littlebirdelectronics/shakey/Images/3-Shakeys.jpg

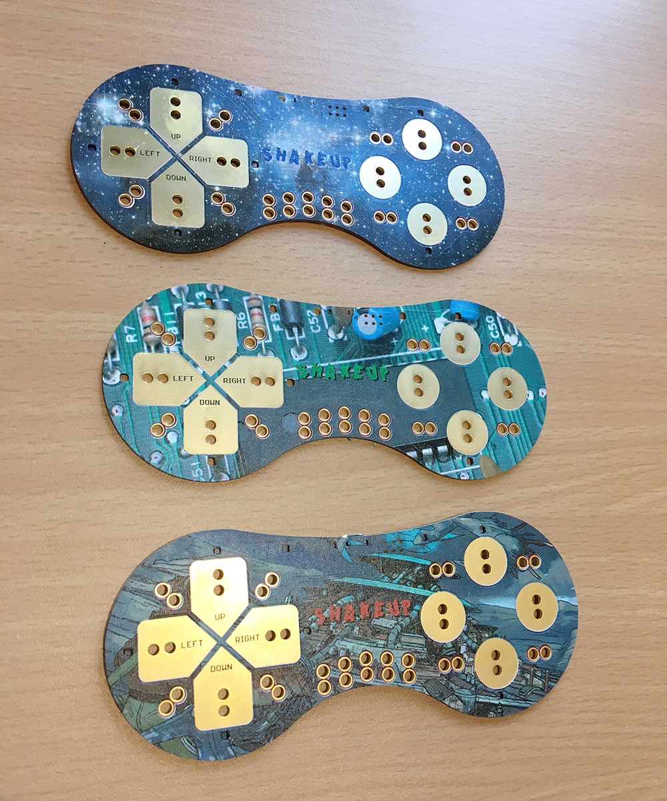
Images/3-Shakeys.jpg
