littlebirdelectronics/shakey/Images/PCB Back.jpg

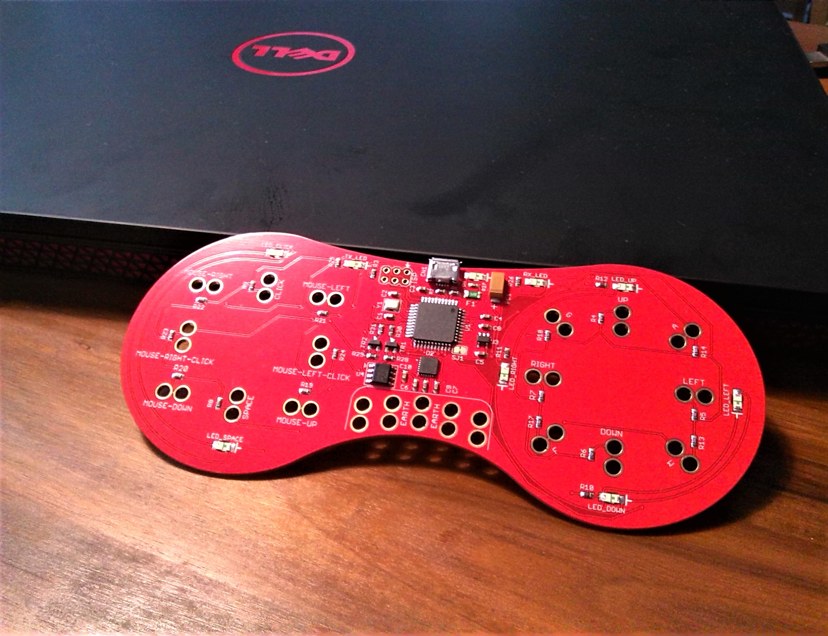
Images/PCB Back.jpg
