littlebirdelectronics/shakey/Images/abstract-small.jpg

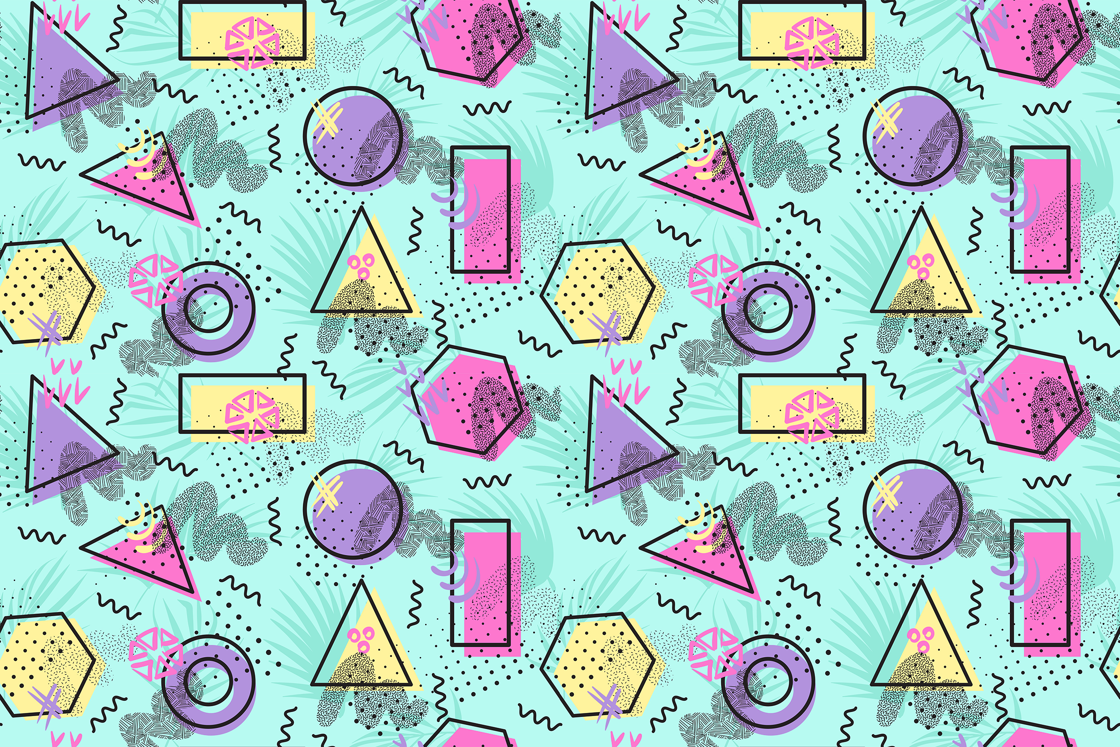
Images/abstract-small.jpg
