littlebirdelectronics/shakey/Images/jlcpcb_complain.JPG

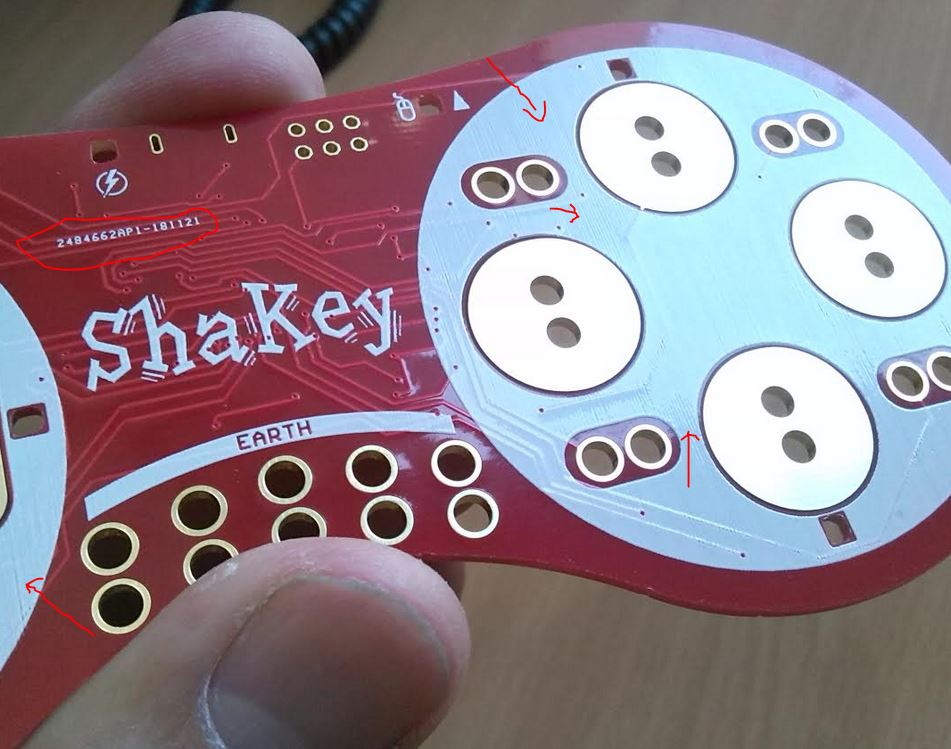
Images/jlcpcb_complain.JPG
