littlebirdelectronics/shakey/Images/MOS6581_chtaube061229.jpg

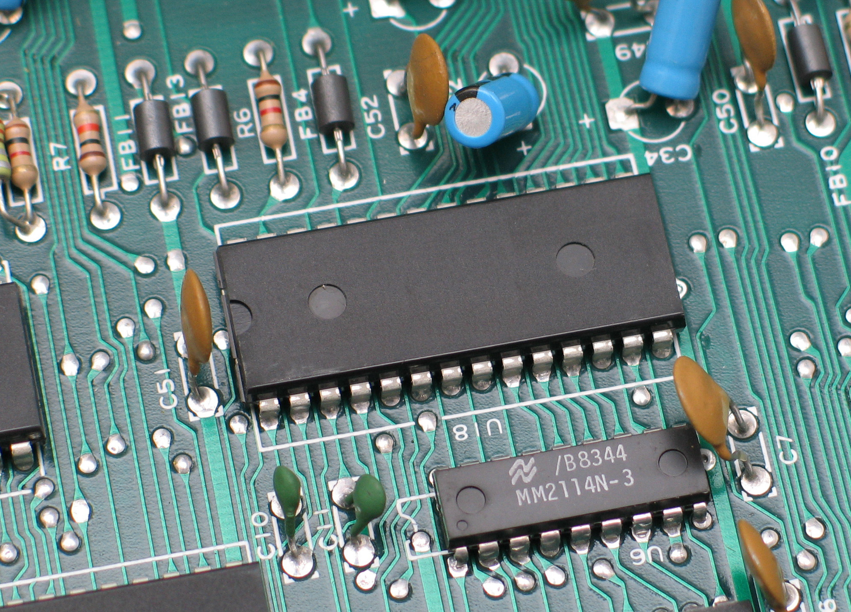
Images/MOS6581_chtaube061229.jpg
