littlebirdelectronics/shakey/Images/PCB Front.jpg

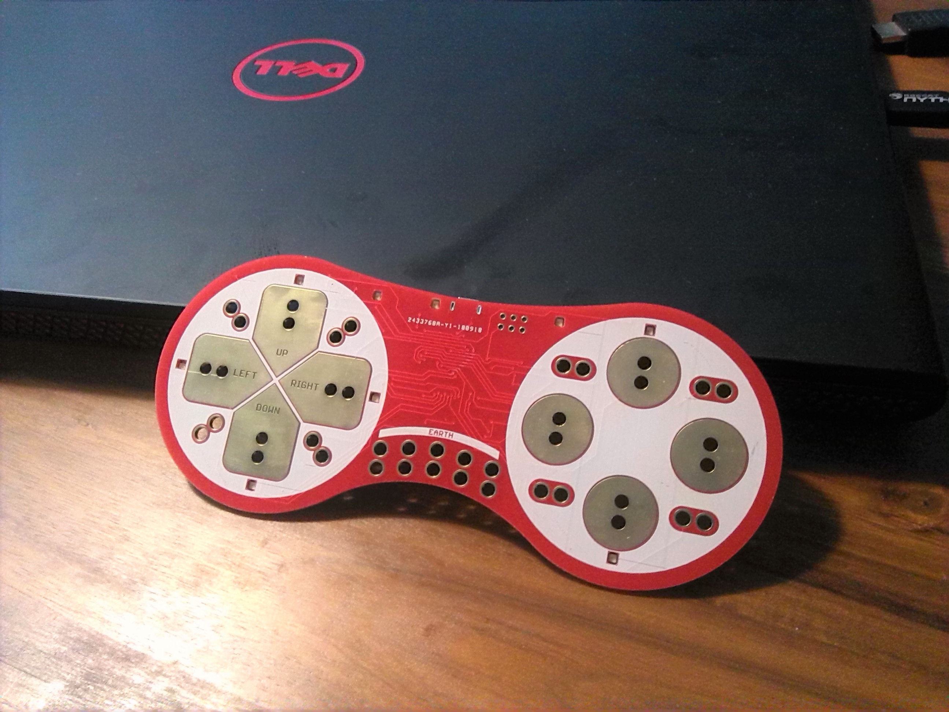
Images/PCB Front.jpg
