littlebirdelectronics/shakey/Production/BOM/2018-11-02T052132.xlsx

Index | Quantity | Part Number | Manufacturer Part Number | Description | Customer Reference | Available | Backorder | Unit Price | Extended Price USD
1 | 1000 | AP2112K-3.3TRG1DIDKR-ND | AP2112K-3.3TRG1 | IC REG LINEAR 3.3V 600MA SOT25 | U3 | 1000 | 0 | 0.13041 | 130.41
2 | 1000 | ATMEGA32U4-AU-ND | ATMEGA32U4-AU | IC MCU 8BIT 32KB FLASH 44TQFP | U1 | 1000 | 0 | 3.4196 | 3419.60
3 | 4000 | 1276-1258-2-ND | CL10F104ZO8NNNC | CAP CER 0.1UF 16V Y5V 0603 | C4, C6, C10 | 4000 | 0 | 0.00693 | 27.72
4 | 4000 | 1276-2082-2-ND | CL10B474KA8NFNC | CAP CER 0.47UF 25V X7R 0603 | C9 | 4000 | 0 | 0.01651 | 66.02
5 | 4000 | 1276-6524-2-ND | CL10B105MO8NNWC | CAP CER 1UF 16V X7R 0603 | C3, C5, C8 | 4000 | 0 | 0.00787 | 31.46
6 | 4000 | 1276-1888-2-ND | CL10A225MQ8NNNC | CAP CER 2.2UF 6.3V X5R 0603 | C7 | 4000 | 0 | 0.02093 | 83.72
7 | 1000 | 478-10747-6-ND | TAJC106M016SNJ | CAP TANT 10UF 20% 16V 2312 | PC1 | 1000 | 0 | 0.14864 | 148.64
8 | 1000 | SER4046TR-ND | FA-238 16.0000MB-K3 | CRYSTAL 16.00 MHZ 10PF SMD | Y1 | 1000 | 0 | 0.19251 | 192.51
9 | 1000 | 1428-1059-6-ND | ICM-20689 | IMU ACCEL/GYRO/TEMP I2C/SPI QFN | U2 | 1000 | 0 | 2.98965 | 2989.65
10 | 6000 | 160-1456-2-ND | LTST-C230KGKT | LED GREEN CLEAR CHIP SMD | LED_CLICK, LED_DOWN, LED_LEFT, LED_RIGHT, LED_SP | 6000 | 0 | 0.0476 | 285.60
11 | 1000 | 160-1457-6-ND | LTST-C230KRKT | LED RED CLEAR CHIP SMD | ON | 1000 | 0 | 0.06054 | 60.54
12 | 2000 | 160-1458-6-ND | LTST-C230KSKT | LED YELLOW CLEAR CHIP SMD | RX_LED,TX_LED | 2000 | 0 | 0.07304 | 146.08
13 | 1000 | 568-10295-6-ND | LM75AD,118 | SENSOR DIGITAL -55C-125C 8SO | U4 | 1000 | 0 | 0.33734 | 337.34
14 | 2000 | BSS138DKR-ND | BSS138 | MOSFET N-CH 50V 220MA SOT-23 | TR1,TR2 | 2000 | 0 | 0.06041 | 120.82
15 | 1000 | 507-1802-6-ND | 0ZCJ0050FF2G | PTC RESET FUSE 8V 500MA 1206 | F1 | 1000 | 0 | 0.07996 | 79.96
16 | 5000 | RMCF0603JT10K0TR-ND | RMCF0603JT10K0 | RES 10K OHM 5% 1/10W 0603 | R3, R28, R29, R30, R31 | 5000 | 0 | 0.00188 | 9.41
17 | 5000 | 311-1.0KGRTR-ND | RC0603JR-071KL | RES SMD 1K OHM 5% 1/10W 0603 | R25, R26, R27 | 5000 | 0 | 0.00268 | 13.41
18 | 20000 | P22MGTR-ND | ERJ-3GEYK226V | RES SMD 22M OHM 10% 1/10W 0603 | R4, R5, R6, R7, R8, R9, R13, R14, R17, R18, R19, | 20000 | 0 | 0.0028 | 55.94
19 | 5000 | RMCF0603JT22R0TR-ND | RMCF0603JT22R0 | RES 22 OHM 5% 1/10W 0603 | R1, R2 | 5000 | 0 | 0.00188 | 9.41
20 | 5000 | RMCF0603JT330RTR-ND | RMCF0603JT330R | RES 330 OHM 5% 1/10W 0603 | R10, R11, R12 | 5000 | 0 | 0.00188 | 9.41
21 | 1000 | SCP390-ND | 10057 | BAG 5X7" STATIC SHIELD 1=1EA |  | 1000 | 0 | 0.089 | 89.00
22 | 4000 | 1276-2149-2-ND | CL10C100CB81PNC | CAP CER 10PF 50V C0G/NP0 0603 | C1,C2 | 4000 | 0 | 0.01648 | 65.90
