littlebirdelectronics/shakey/Production/BOM/Shakey_default_BOM_values.xls

Total Price | Need Qty | Qty | Value | Device | Parts | Library | Description | DESCRIPTION | MF | MPN | OC_DIGIKEY | SUPPLIER | UNITPRICE | URL
0.13041 | 1 | 1 | AP2210K-3.3TRG1 | AP2210K-3.3TRG1 | U3 | SixthLogic | The AP2210 is a 300mA ULDO regulator which provides very low | IC REG LDO 3.3V 0.3A SOT23-5 | Diodes Inc | AP2112K-3.3TRG1 | AP2112K-3.3TRG1DIDKR-ND |  | $0.13041 | https://www.digikey.com/product-detail/en/diodes-incorporated/AP2210K-3.3TRG1/AP2210K-3.3TRG1DITR-ND/4470819 | Replace with AP2112K-3.3TRG1 to match EagLED
3.04 | 1 | 1 | ATMEGA32U4-AU | ATMEGA32U4-AU | U1 | SixthLogic | Atmel ATmega32u4 MCU, 32KByte | IC MCU 8BIT 32KB FLASH | Microchip Technology | ATMEGA32U4-AU | ATMEGA32U4-AU-ND |  | $3.04 | https://www.digikey.com/product-detail/en/microchip-technology/ATMEGA32U4-AU/ATMEGA32U4-AU-ND/1914602
0.02079 | 3 | 3 | 0.1uF | C-EUC0603 | C4, C6, C10 | rcl | CAPACITOR, European symbol | CAP CER 0.1UF 50V X7R 0603 | Samsung Electro-Mechanics | CL10B104KB8NNNC | 1276-1000-2-ND | Digikey | $0.00693 | https://www.digikey.com/product-detail/en/samsung-electro-mechanics/CL10F104ZO8NNNC/1276-1258-2-ND/3886916
0.01651 | 1 | 1 | 0.47uF | C-EUC0603 | C9 | rcl | CAPACITOR, European symbol | CAP CER 0.47UF 16V X7R 0603 | Murata Electronics North America | GCM188R71C474KA55D | 490-4775-2-ND | Digikey | $0.01651 | https://www.digikey.com/product-detail/en/CL10B474KA8NFNC/1276-2082-2-ND/3887740/?itemSeq=276083693
0.02361 | 3 | 3 | 1uF | C-EUC0603 | C3, C5, C8 | rcl | CAPACITOR, European symbol | CAP CER 1UF 25V X5R 0603 | Samsung Electro-Mechanics | CL10A105KA8NNNC | 1276-1102-2-ND | Digikey | $0.00787 | https://www.digikey.com/product-detail/en/samsung-electro-mechanics/CL10B105MO8NNWC/1276-6524-2-ND/5961008
0.02093 | 1 | 1 | 2.2uF | C-EUC0603 | C7 | rcl | CAPACITOR, European symbol | CAP CER 2.2UF 16V X5R 0603 | Samsung Electro-Mechanics | CL10A225KO8NNNC | 1276-1040-2-ND | Digikey | $0.02093 | https://www.digikey.com/product-detail/en/samsung-electro-mechanics/CL10A225MQ8NNNC/1276-1888-2-ND/3887546
0.03014 | 2 | 2 | 22p | C-EUC0603 | C1, C2 | rcl | CAPACITOR, European symbol | CAP CER 22PF 16V C0G/NP0 0603 | KEMET | C0603C220K4GACTU | 399-9031-2-ND | Digikey | $0.01507 | https://www.digikey.com/product-detail/en/yageo/CC0603JRNPO0BN220/311-1755-2-ND/5195164
0.14864 | 1 | 1 | 10uF | CAP_POL-CT6032 | PC1 | SixthLogic | Capacitor with Polarity | CAP TANT 10UF 20V 10% 2312 | KEMET | T491C106K020AT7280 | 399-10158-2-ND | Digikey | $0.14864 | https://www.digikey.com/product-detail/en/avx-corporation/TAJC106M016SNJ/478-10747-6-ND/7537038
0.07954 | 1 | 1 | CONN_USB-4UCON-11071 | CONN_USB-4UCON-11071 | CN1 | SixthLogic | USB Connector | B TYPE FEMALE 05P SMT 90ﾰ WITHOUT POST 2 SHELL TABS | 4UCON | 11071 |  |  | $0.07954 | http://www.4uconnector.com/online/Itemadrawing.asp?fldseries=11071&seriesno_a=1006
0.19251 | 1 | 1 | 16Mhz | CRYSTAL_GROUNDED_2GND-FA-238 | Y1 | SixthLogic | 4 PIN SMD Crystal | CRYSTAL 16.0000MHZ 18PF SMD | EPSON | FA-238 16.0000MB-C3 | SER3686TR-ND | Digikey | $0.19251 | https://www.digikey.com/product-detail/en/FA-238+16.0000MB-K3/SER4046TR-ND/5175005/?itemSeq=276086705
3.10196 | 1 | 1 | ICM-20689 | ICM-20689 | U2 | SixthLogic | High Performance 6-Axis MEMS MotionTrackingﾙ Device in 4x4 mm Package | IMU ACCEL/GYRO/TEMP I2C/SPI QFN | TDK InvenSense | ICM-20689 | 1428-1059-2-ND | Digikey | $3.10196 | https://www.digikey.com/product-detail/en/tdk-invensense/ICM-20689/1428-1059-2-ND/5872869
0.28704 | 6 | 6 | GREEN | LED-1206-LTST-BOTTOM | LED_CLICK, LED_DOWN, LED_LEFT, LED_RIGHT, LED_SPACE, LED_UP | SixthLogic |  | LED GREEN CLEAR CHIP SMD | Lite-On Inc. | LTST-C230KGKT | 160-1456-2-ND | Digikey | $0.04784 | https://www.digikey.com/product-detail/en/lite-on-inc/LTST-C230KGKT/160-1456-2-ND/386855
0.05668 | 1 | 1 | RED | LED-1206-LTST-BOTTOM | ON | SixthLogic |  | LED RED CLEAR CHIP SMD | Lite-On Inc. | LTST-C230KRKT | 160-1457-2-ND | Digikey | $0.05668 | https://www.digikey.com/product-detail/en/lite-on-inc/LTST-C230KRKT/160-1457-2-ND/386857
0.1119 | 2 | 2 | YELLOW | LED-1206-LTST-BOTTOM | RX_LED, TX_LED | SixthLogic |  | LED YELLOW CLEAR CHIP SMD | Lite-On Inc. | LTST-C230KSKT | 160-1458-2-ND | Digikey | $0.05595 | https://www.digikey.com/product-detail/en/lite-on-inc/LTST-C230KSKT/160-1458-2-ND/386859
0.28743 | 1 | 1 | LM75AD | LM75AD | U4 | SixthLogic | LM75 | SENSOR DIGITAL -55C-125C 8SO | NXP USA Inc. | LM75AD,118 | 568-10295-2-ND | Digikey | $0.28743 | https://www.digikey.com/product-detail/en/nxp-usa-inc/LM75AD118/568-10295-2-ND/1692795
0.12782 | 2 | 2 | BSS138 | MOSFET-N-BSS138 | TR1, TR2 | SixthLogic |  | MOSFET N-CH 50V 220MA SOT-23 | ON Semiconductor | BSS138 | BSS138TR-ND | Digikey | $0.06391 | https://www.digikey.com/product-detail/en/on-semiconductor/BSS138/BSS138TR-ND/244210
0.07996 | 1 | 1 | 500mA | PPTC-1206 | F1 | SixthLogic |  | PTC RESET FUSE 8V 500MA 1206 | Bel Fuse Inc. | 0ZCJ0050FF2G | 507-1802-6-ND | Digikey | $0.07996 | https://www.digikey.com/product-detail/en/bel-fuse-inc/0ZCJ0050FF2G/507-1802-6-ND/4156237
0.0094 | 5 | 5 | 10K | R-EU_R0603 | R3, R28, R29, R30, R31 | rcl | RESISTOR, European symbol | RES 10K OHM 5% 1/10W 0603 | Stackpole Electronics Inc. | RMCF0603JG10K0 | RMCF0603JG10K0TR-ND | Digikey | $0.00188 | https://www.digikey.com/product-detail/en/stackpole-electronics-inc/RMCF0603JG10K0/RMCF0603JG10K0TR-ND/1712133
0.00804 | 3 | 3 | 1K | R-EU_R0603 | R25, R26, R27 | rcl | RESISTOR, European symbol | RES SMD 1K OHM 5% 1/10W 0603 | Yageo | RC0603JR-071KL | 311-1.0KGRTR-ND | Digikey | $0.00268 | https://www.digikey.com/product-detail/en/yageo/RC0603JR-071KL/311-1.0KGRTR-ND/726677
0.0448 | 16 | 16 | 22M | R-EU_R0603 | R4, R5, R6, R7, R8, R9, R13, R14, R17, R18, R19, R20, R21, R22, R23, R24 | rcl | RESISTOR, European symbol | RES SMD 22M OHM 10% 1/10W 0603 | Panasonic Electronic Components | ERJ-3GEYK226V | P22MGTR-ND | Digikey | $0.00280 | https://www.digikey.com/product-detail/en/panasonic-electronic-components/ERJ-3GEYK226V/P22MGTR-ND/282153
0.00376 | 2 | 2 | 22R | R-EU_R0603 | R1, R2 | rcl | RESISTOR, European symbol | RES 22 OHM 5% 1/10W 0603 | Stackpole Electronics Inc. | RMCF0603JT22R0 | RMCF0603JT22R0TR-ND | Digikey | $0.00188 | https://www.digikey.com/product-detail/en/stackpole-electronics-inc/RMCF0603JT22R0/RMCF0603JT22R0TR-ND/1758012
0.00564 | 3 | 3 | 330R | R-EU_R0603 | R10, R11, R12 | rcl | RESISTOR, European symbol | RES 330 OHM 5% 1/10W 0603 | Stackpole Electronics Inc. | RMCF0603JT330R | RMCF0603JT330RTR-ND | Digikey | $0.00188 | https://www.digikey.com/product-detail/en/stackpole-electronics-inc/RMCF0603JT330R/RMCF0603JT330RTR-ND/1757998
0.089 | 1 | 1 |  |  |  |  |  | Anti-static bag 5x7” |  |  |  |  | $0.089
7.91651
Make Qty | 1
