littlebirdelectronics/shakey/Images/SNES_Outline2.dxf

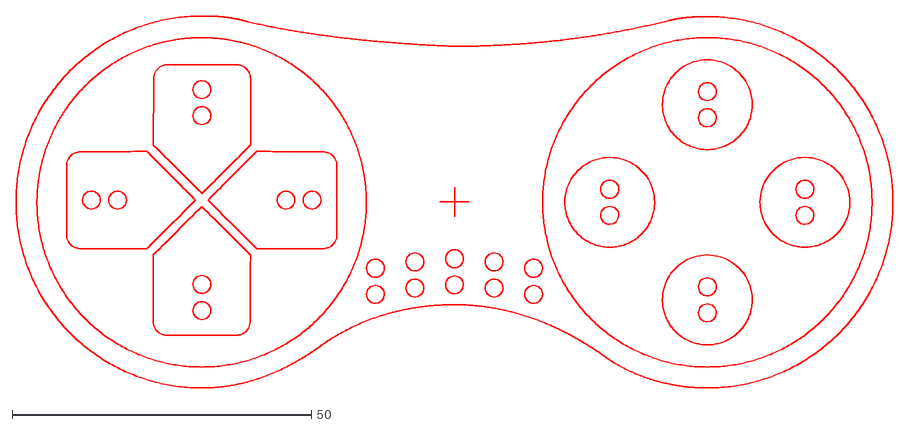
[picture p7: CAD file, 2019-06-05]
Images/SNES_Outline2.dxf
146.4 x 62.1
