littlebirdelectronics/shakey/Shakey.dxf

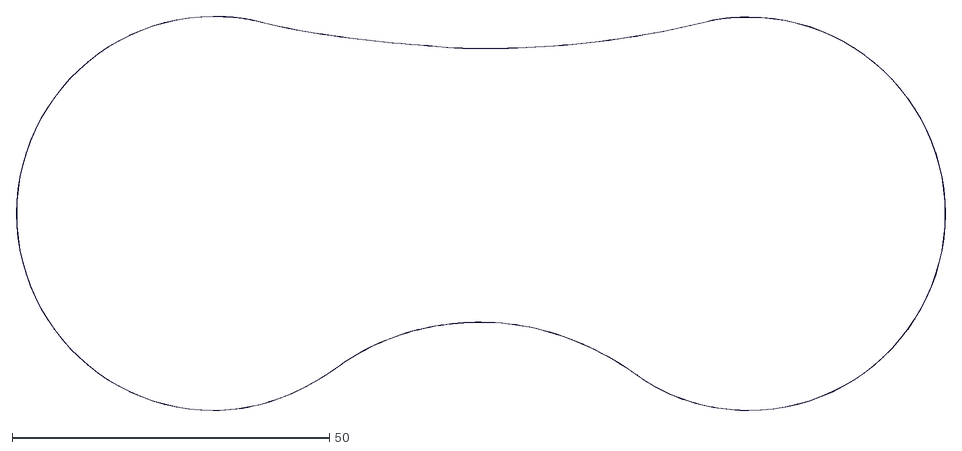
[picture p8: CAD file, 2018-12-04]
Shakey.dxf
146.5 x 62.2
