littlebirdelectronics/shakey/Images/TestJig.dxf

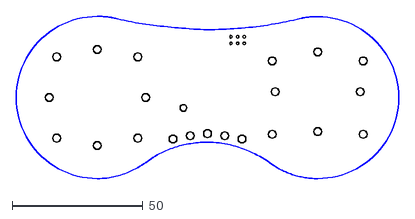
[picture p9: CAD file, 2019-03-15]
Images/TestJig.dxf
146.4 x 62.1
