littlebirdelectronics/shakey/Images/Untitled.dxf

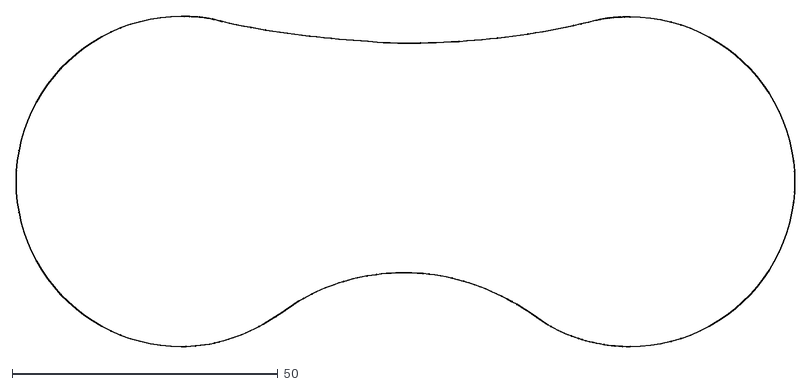
[picture p10: CAD file, 2018-12-04]
Images/Untitled.dxf
146.5 x 62.2
