littlebirdelectronics/shakey/Images/Outline.dxf

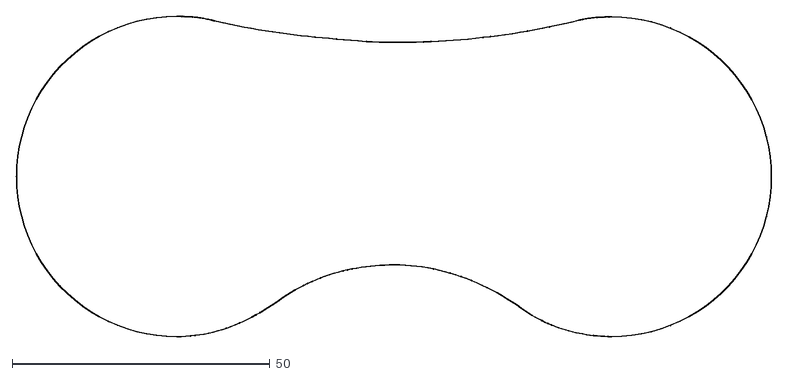
[picture p11: CAD file, 2018-12-04]
Images/Outline.dxf
146.5 x 62.2
