littlebirdelectronics/shakey/Images/side_holder.dxf

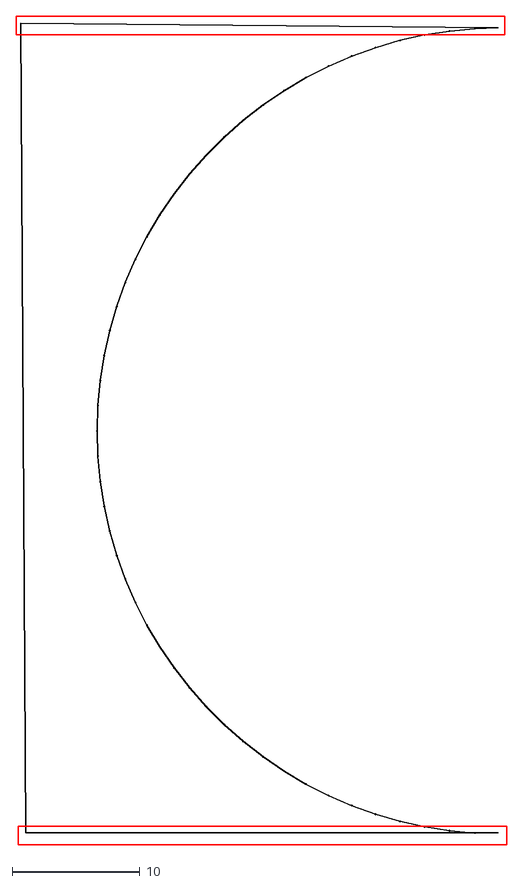
[picture p12: CAD file, 2018-12-04]
Images/side_holder.dxf
38.4 x 64.8
