littlebirdelectronics/shakey/Images/Shakey-Outline.dxf

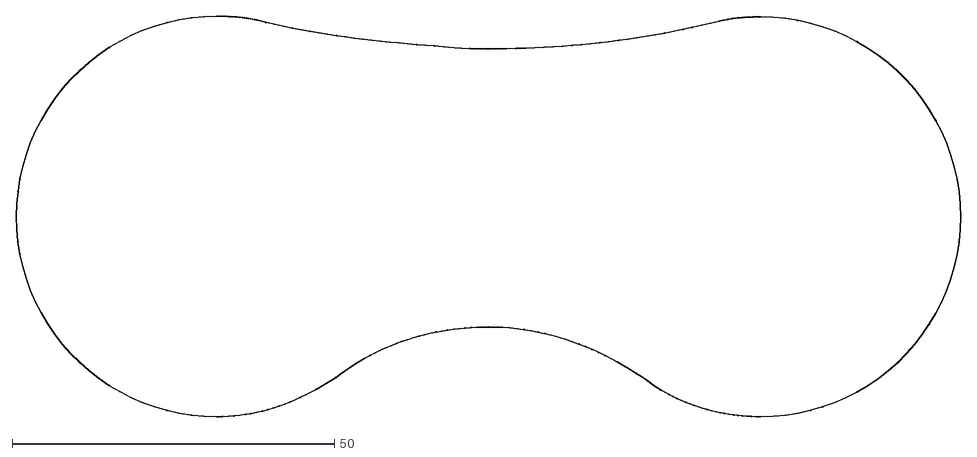
[picture p13: CAD file, 2018-12-04]
Images/Shakey-Outline.dxf
146.5 x 62.2
