littlebirdelectronics/shakey/Images/Australian-Made.dxf

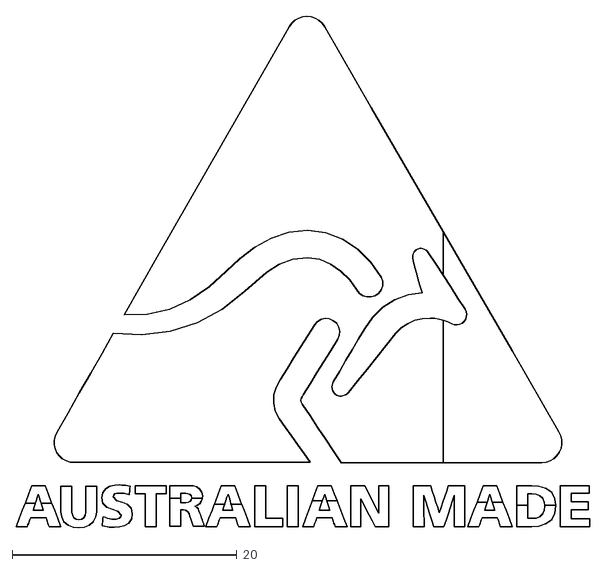
[picture p14: CAD file, 2018-11-09]
Images/Australian-Made.dxf
51.1 x 45.6
