littlebirdelectronics/shakey/Images/test_made_in_australia.dxf

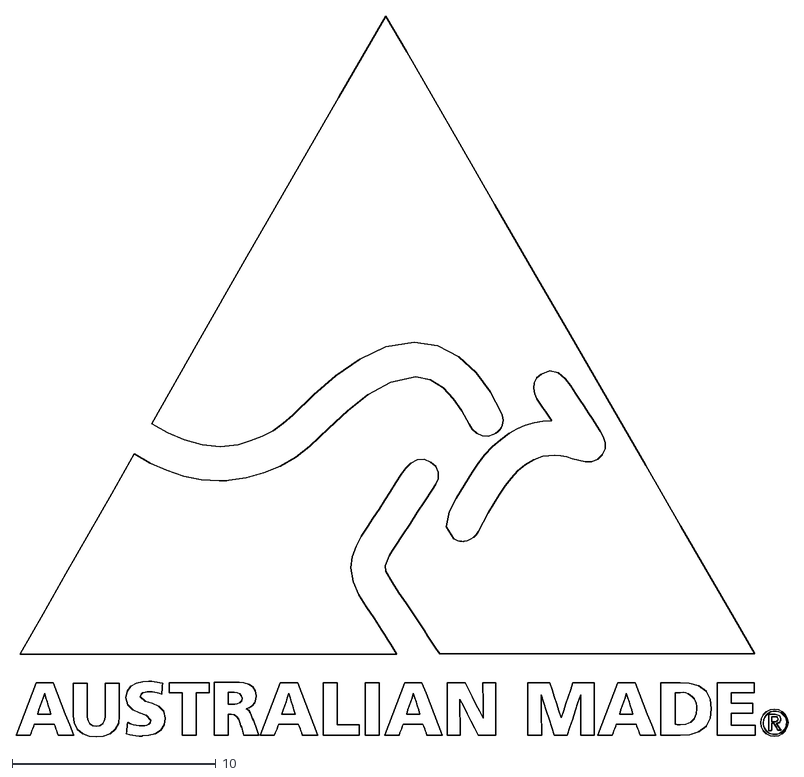
[picture p15: CAD file, 2018-10-26]
Images/test_made_in_australia.dxf
37.9 x 35.4
