littlebirdelectronics/shakey/Images/shakey-logo.dxf

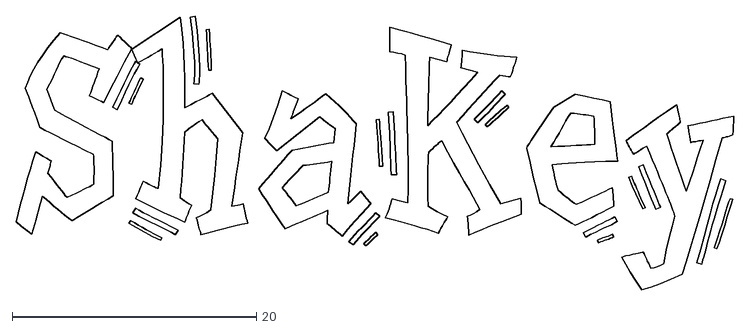
[picture p16: CAD file, 2018-10-24]
Images/shakey-logo.dxf
58.8 x 22.4
