littlebirdelectronics/shakey/Images/test.dxf

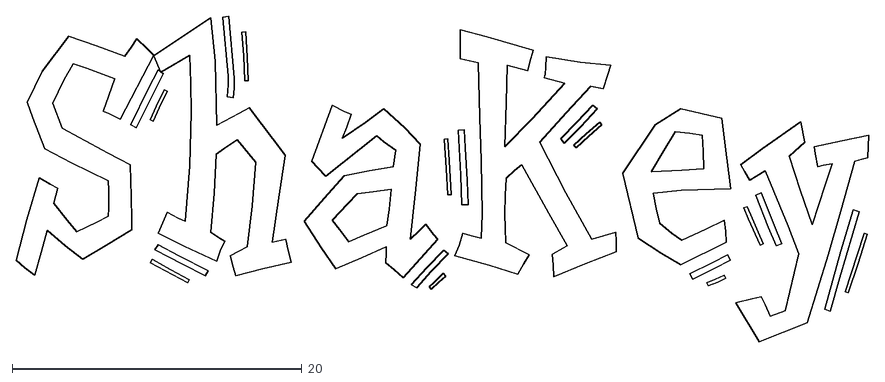
[picture p17: CAD file, 2018-10-24]
Images/test.dxf
58.8 x 22.4
