littlebirdelectronics/shakey/Images/4UCON-11071.dxf

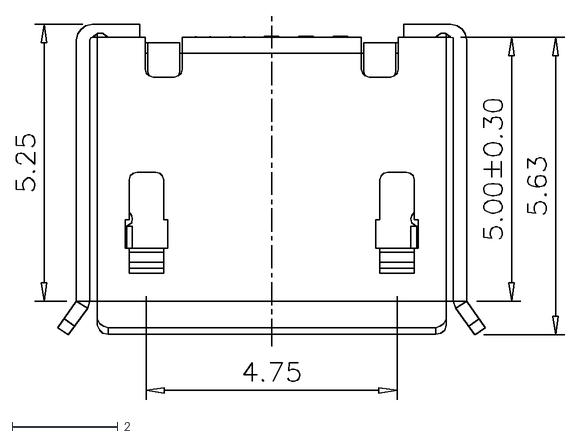
[picture p18: CAD file, 2018-09-18]
Images/4UCON-11071.dxf
10.4 x 7.24
