littlebirdelectronics/shakey/Images/SNES_Outline.dxf

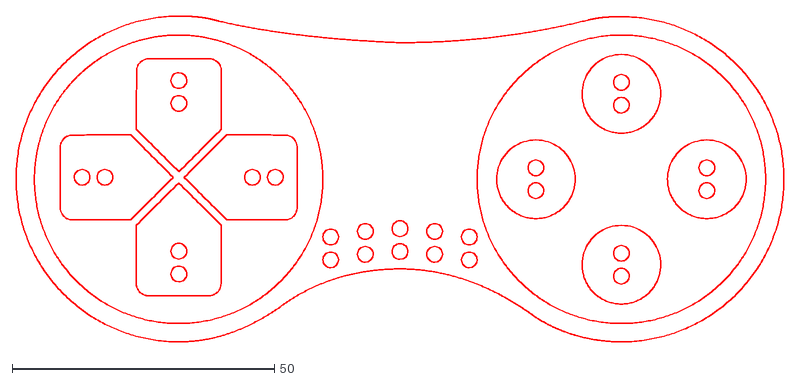
[picture p19: CAD file, 2018-09-12]
Images/SNES_Outline.dxf
146.4 x 62.1
