littlebirdelectronics/shakey/Images/SNES.dxf

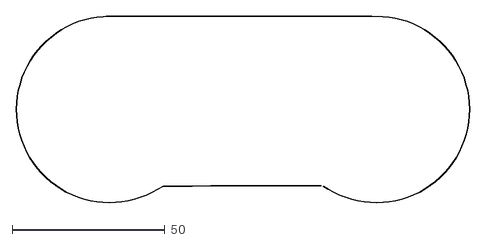
[picture p20: CAD file, 2018-09-08]
Images/SNES.dxf
148.3 x 61.0
