littlebirdelectronics/shakey/Board Manager/04102018/LittleBird/hardware/avr/1.0.1/bootloaders/caterina/build.txt

make clean
make PID=0x2B74 F_CPU=16000000
copy Caterina.hex Caterina-Shakey.hex
