littlebirdelectronics/shakey/Shakey TODO.txt

Shakey Todo

JP
-------------
Check left/right/top/bottom margin for pick and place
Integrate WebUSB change key to Factory

DONE
====
Accel code (DONE)
Temp code (DONE)
Gyro code (DONE)
Fix Mouse Left / Right correct position (might not need this if mouse is using accelerometer) (NO NEED - Changed on software)
Force Caterina Bootloader with a PIN (DONE)
shake to trigger S key (DONE)
WebUSB (Done)
Adjust croc hole size, maybe to 3.1mm (DONE)
Add Keyboard Mouse icon on top layer (DONE)
Add Shakey Logo (DONE)
Add X,Y Z symbol (skip)
Add fiducial (DONE)
Add 3V test point, 5V test point (DONE)
Shakey- check to protect the gold touch (DONE- ignore for now)

LBE
---------------
Refer to google task
