littlebirdelectronics/shakey/Chrome Debug/Entity no found.PNG

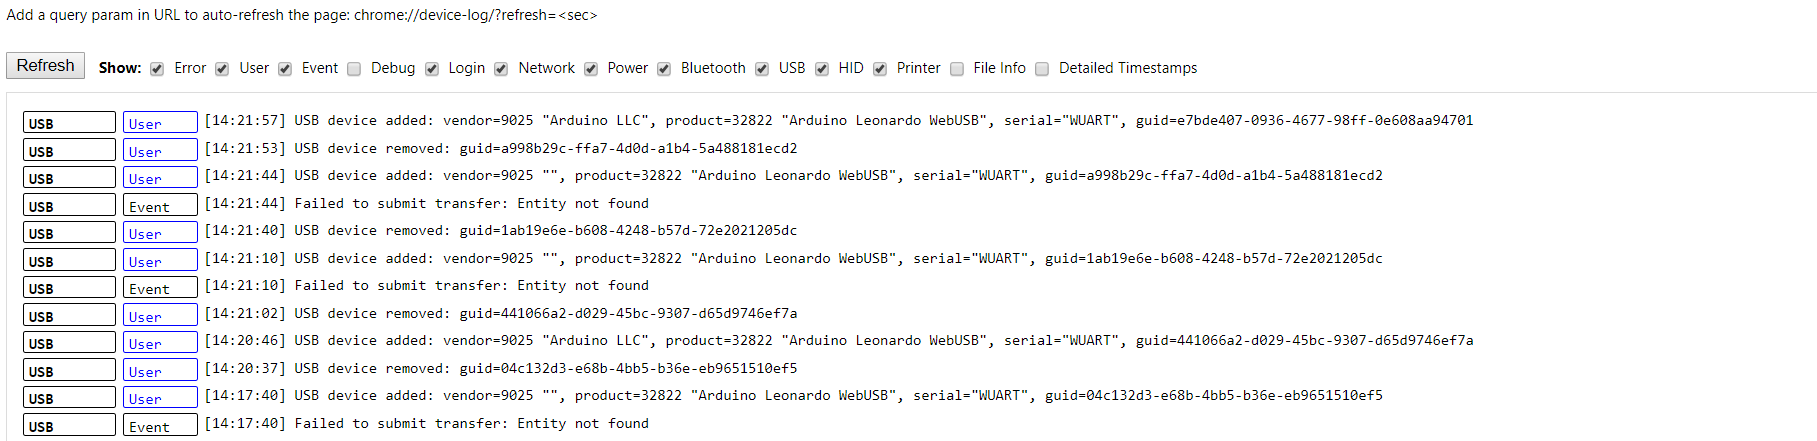
Chrome Debug/Entity no found.PNG
