littlebirdelectronics/shakey/Chrome Debug/ShakeyWebUSB Plug 3 times.JPG

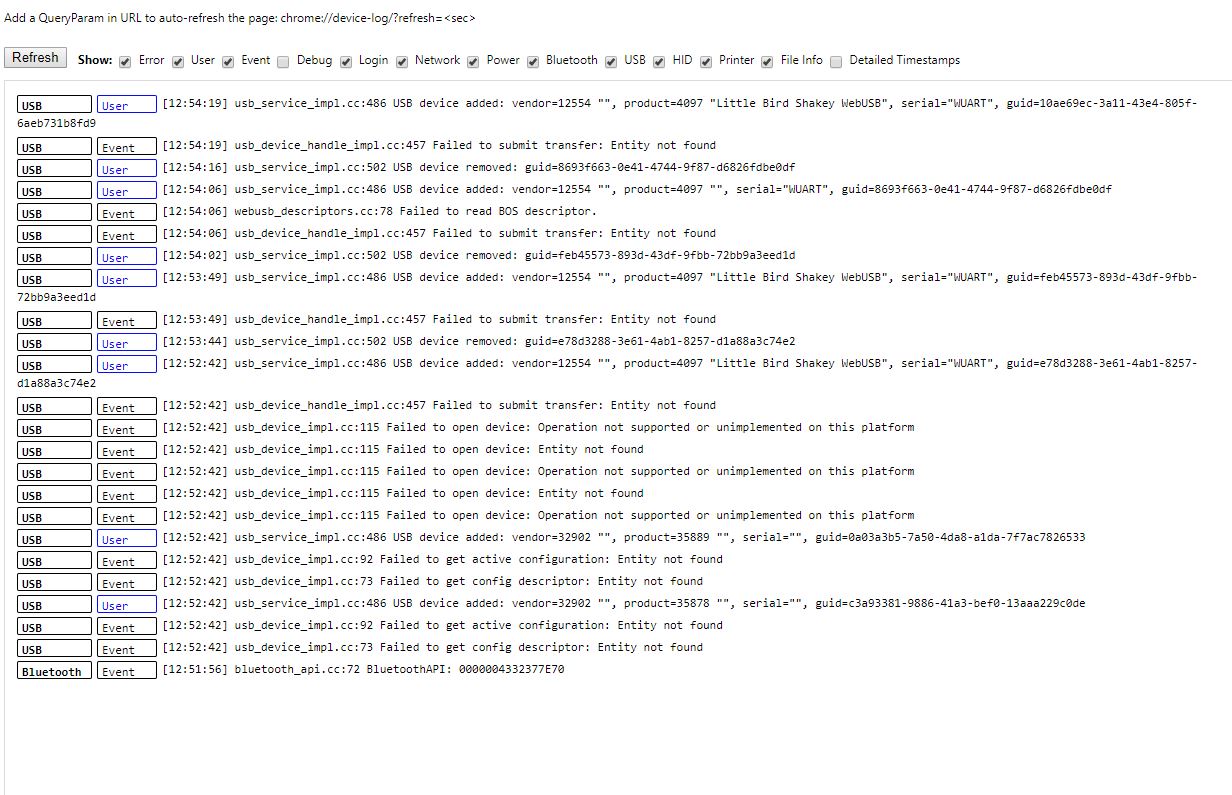
Chrome Debug/ShakeyWebUSB Plug 3 times.JPG
