littlebirdelectronics/shakey/Chrome Debug/Win8.1 Win10 randomly missing descriptions2.PNG

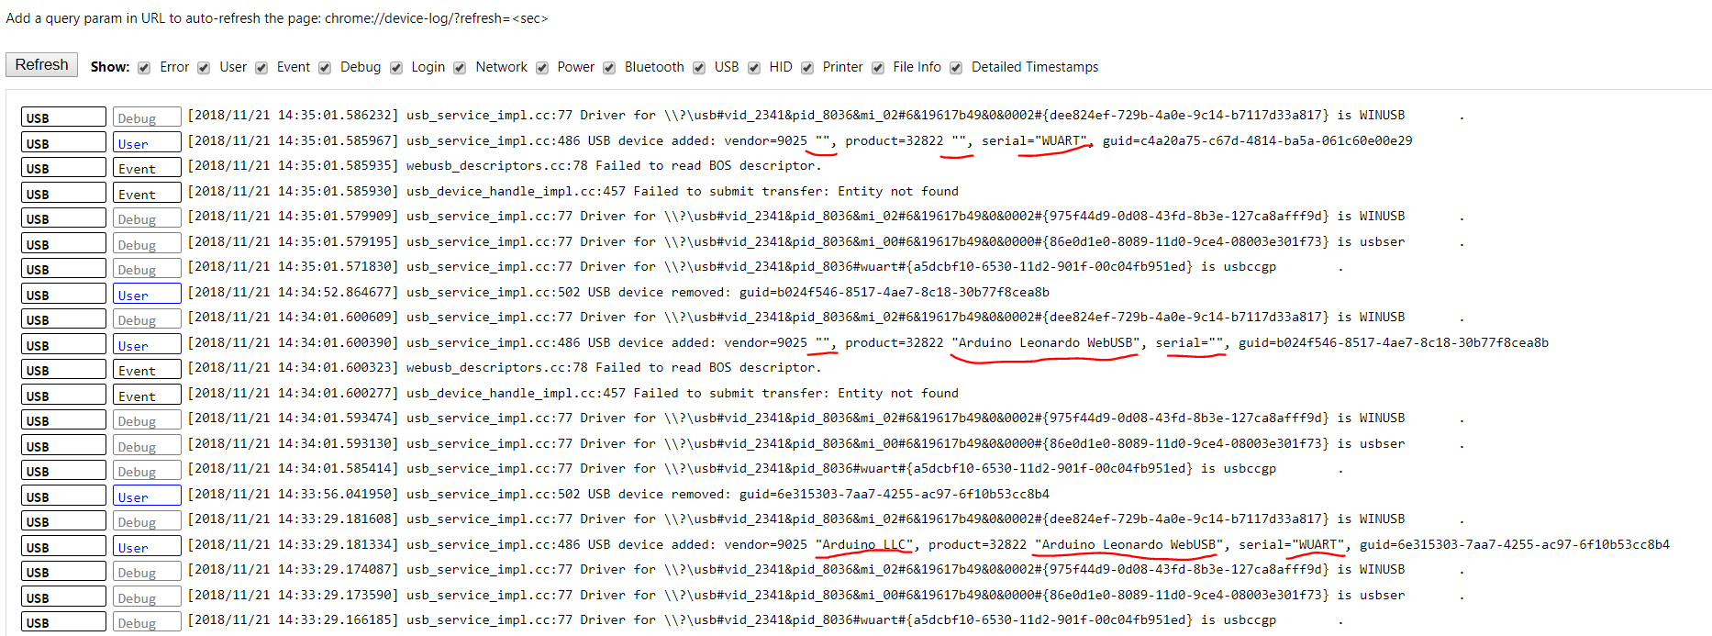
Chrome Debug/Win8.1 Win10 randomly missing descriptions2.PNG
