littlebirdelectronics/shakey/Images/UVPrintShakey.eps.tmp1159124718.pdf

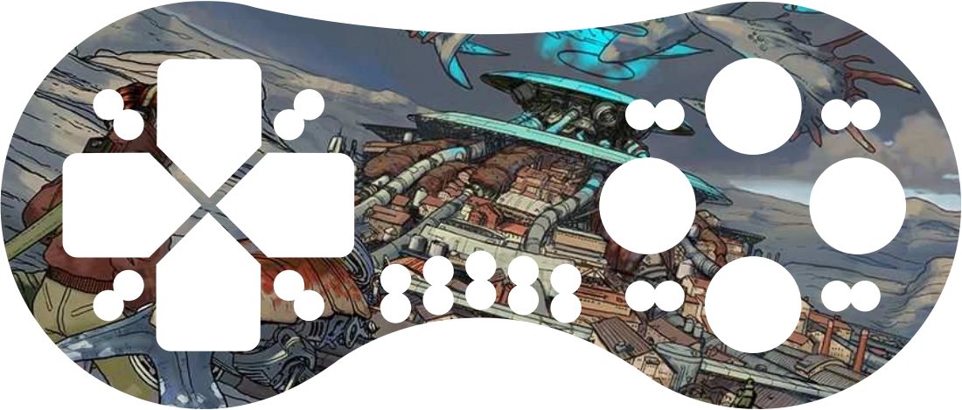
[picture p24: page 1]
