littlebirdelectronics/shakey/Images/UVPrintShakey.pdf

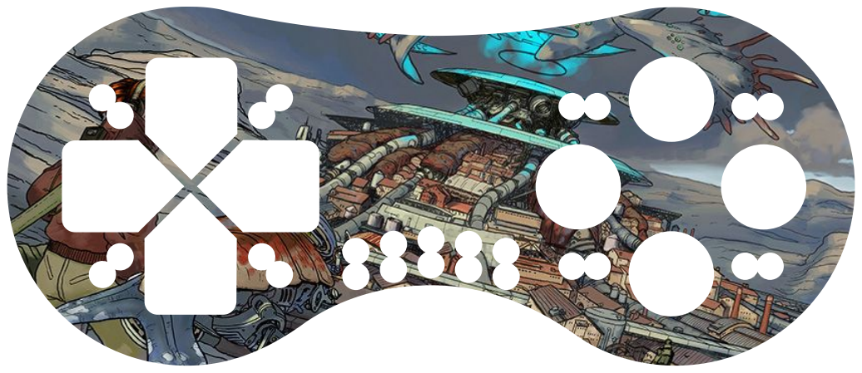
[picture p25: page 1]
