littlebirdelectronics/shakey/Images/SNES_Outline3.pdf

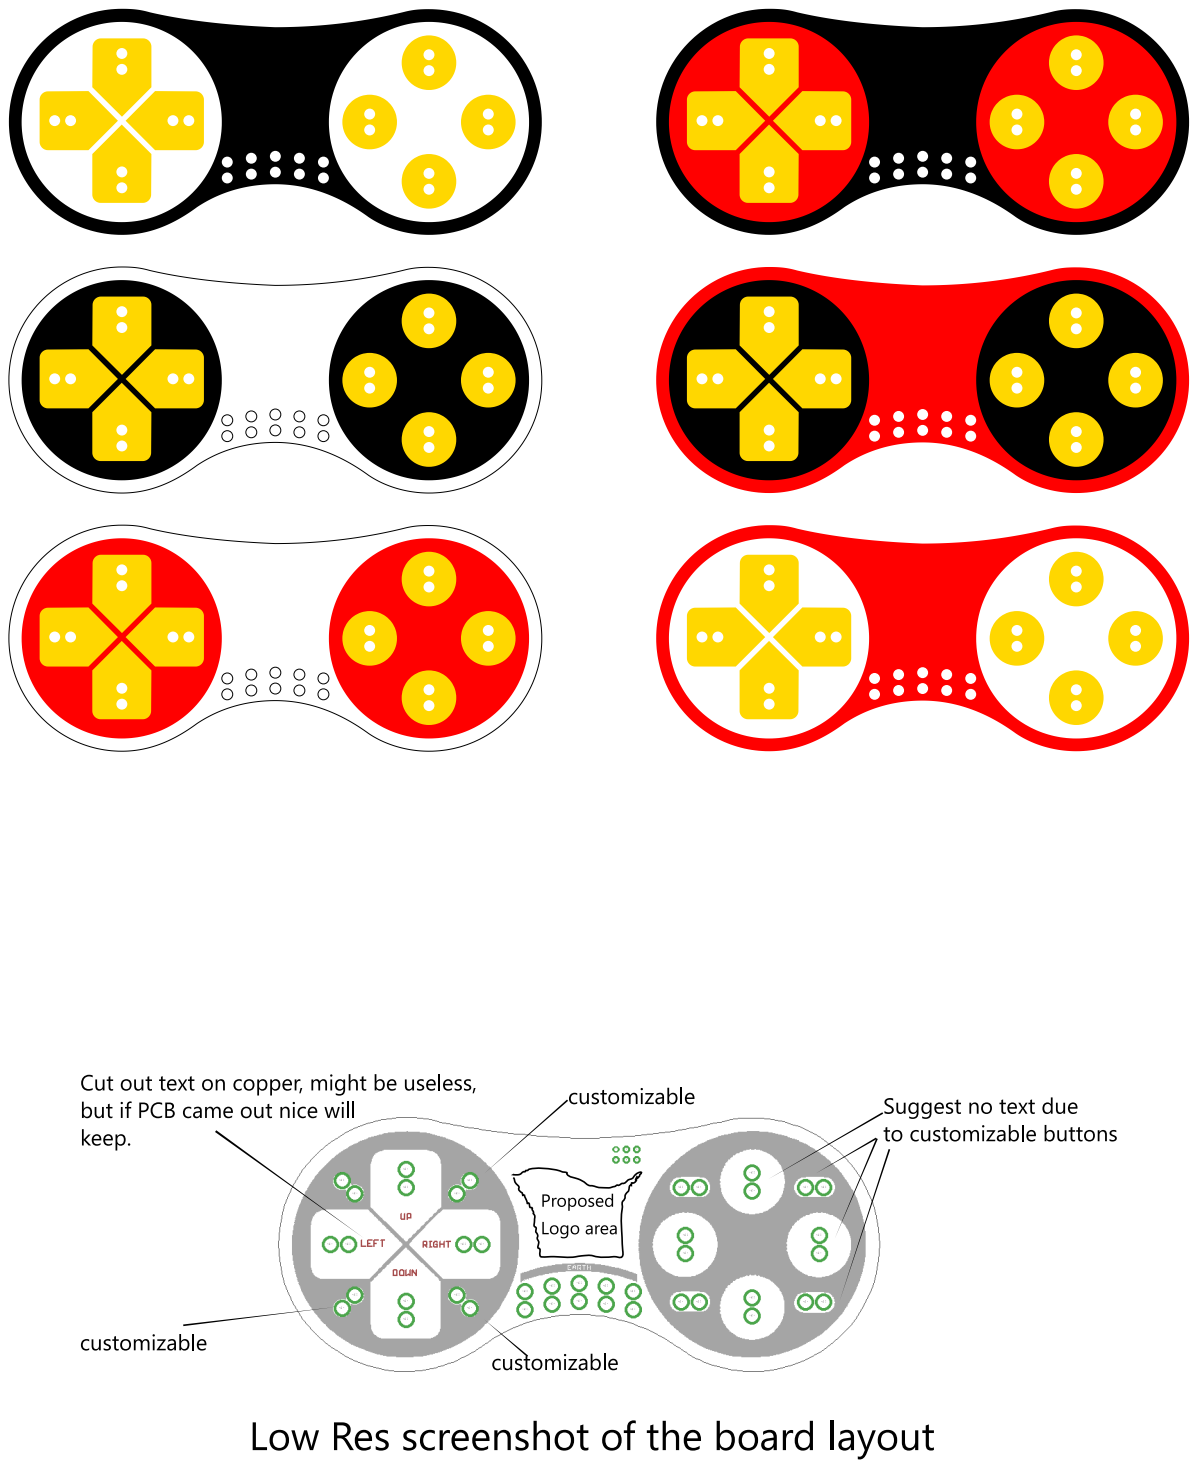
[picture p26: page 1]
