littlebirdelectronics/shakey/Images/Shakey_Outline.pdf

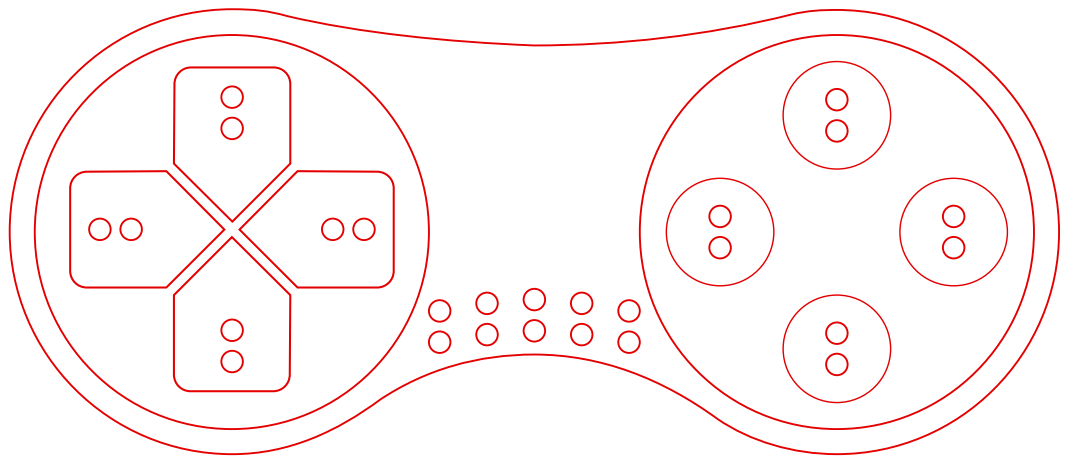
[picture p27: page 1]
