littlebirdelectronics/shakey/Shakey.brd

## EAGLE design Shakey.brd (2019-06-05)

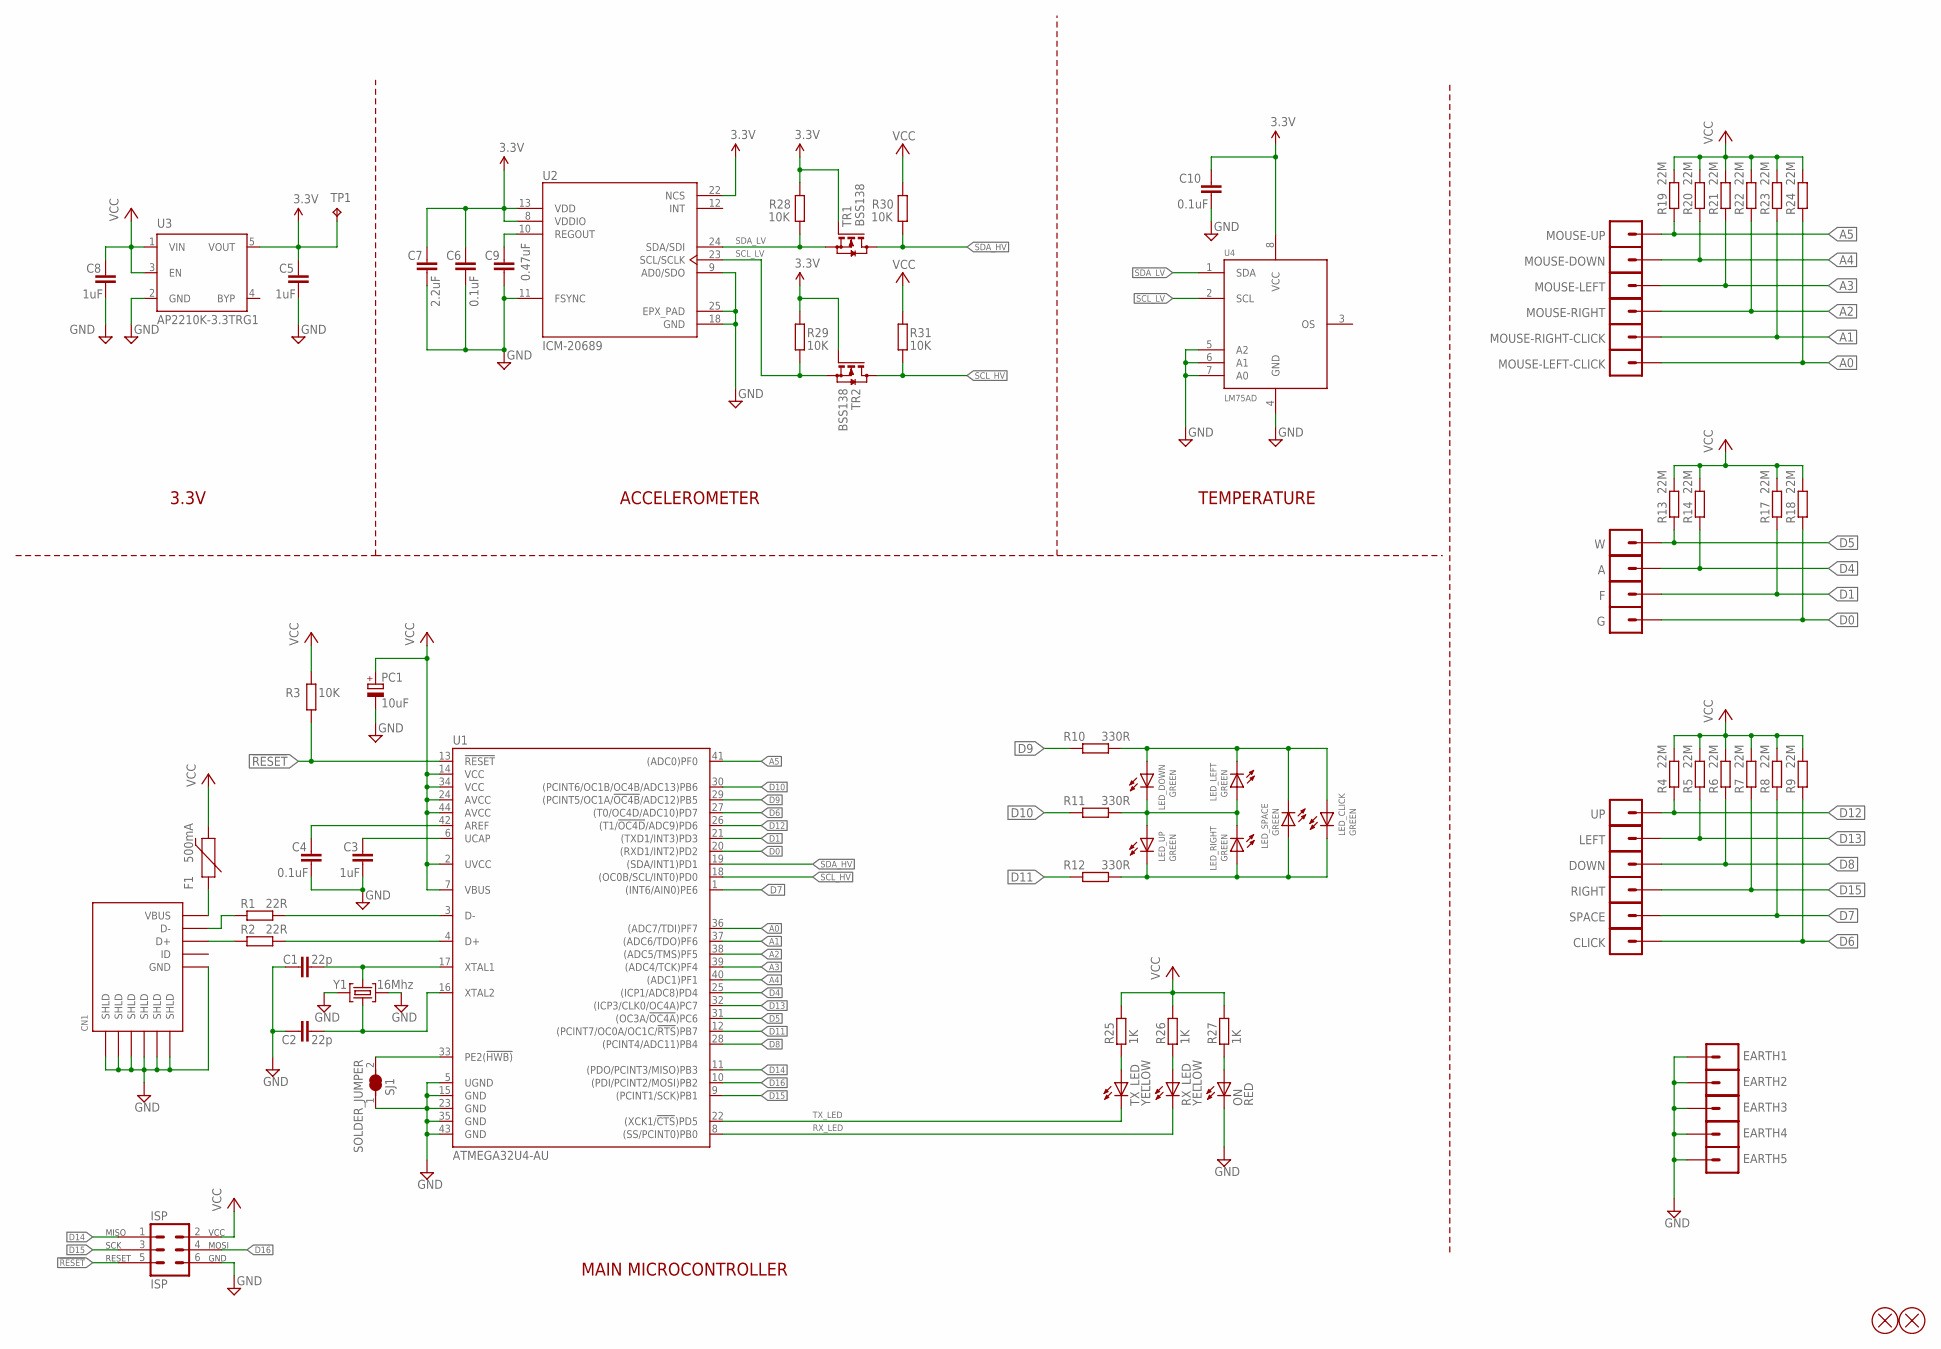
[picture p28: schematic Shakey.sch]

Parts:
A: MA01-1-ALLIGATOR-3.0MM
C1, C2: 22p; C0603; MPN C0603C220K4GACTU
C3, C5, C8: 1uF; C0603; MPN CL10A105KA8NNNC
C4, C6, C10: 0.1uF; C0603; MPN CL10B104KB8NNNC
C7: 2.2uF; C0603; MPN CL10A225KO8NNNC
C9: 0.47uF; C0603; MPN GCM188R71C474KA55D
CLICK: MA01-1-ALLIGATOR-3.0MM
CN1: MicroUSB; 4UCON-11071
DOWN: MA01-1-ALLIGATOR-3.0MM
EARTH1, EARTH2, EARTH3, EARTH4, EARTH5: MA01-1-ALLIGATOR-3.0MM
F: MA01-1-ALLIGATOR-3.0MM
F1: 500mA; PPC-1206; MPN 0ZCJ0050FF2G
G: MA01-1-ALLIGATOR-3.0MM
ISP: ISP; MA03-2
JP1, JP2: FIDUCIAL-1X3MM
LED_CLICK: GREEN; LED-1206-LTST-BOTTOM; MPN LTST-C230KGKT
LED_DOWN: GREEN; LED-1206-LTST-BOTTOM; MPN LTST-C230KGKT
LED_LEFT: GREEN; LED-1206-LTST-BOTTOM; MPN LTST-C230KGKT
LED_RIGHT: GREEN; LED-1206-LTST-BOTTOM; MPN LTST-C230KGKT
LED_SPACE: GREEN; LED-1206-LTST-BOTTOM; MPN LTST-C230KGKT
LED_UP: GREEN; LED-1206-LTST-BOTTOM; MPN LTST-C230KGKT
LEFT: MA01-1-ALLIGATOR-3.0MM
MOUSE-DOWN: MA01-1-ALLIGATOR-3.0MM
MOUSE-LEFT: MA01-1-ALLIGATOR-3.0MM
MOUSE-LEFT-CLICK: MA01-1-ALLIGATOR-3.0MM
MOUSE-RIGHT: MA01-1-ALLIGATOR-3.0MM
MOUSE-RIGHT-CLICK: MA01-1-ALLIGATOR-3.0MM
MOUSE-UP: MA01-1-ALLIGATOR-3.0MM
ON: RED; LED-1206-LTST-BOTTOM; MPN LTST-C230KRKT
PC1: 10uF; CT6032; MPN T491C106K020AT7280
R1, R2: 22R; R0603; MPN RMCF0603JT22R0
R3, R28, R29, R30, R31: 10K; R0603; MPN RMCF0603JG10K0
R4, R5, R6, R7, R8, R9, R13, R14, R17, R18, R19, R20, R21, R22, R23, R24: 22M; R0603; MPN ERJ-3GEYK226V
R10, R11, R12: 330R; R0603; MPN RMCF0603JT330R
R25, R26, R27: 1K; R0603; MPN RC0603JR-071KL
RIGHT: MA01-1-ALLIGATOR-3.0MM
RX_LED: YELLOW; LED-1206-LTST-BOTTOM; MPN LTST-C230KSKT
SJ1: SOLDER_JUMPER; SOLDER_JUMPER_NC
SPACE: MA01-1-ALLIGATOR-3.0MM
TP1: TESTPAD; TP-2.54MM
TR1, TR2: BSS138; SOT23; MPN BSS138
TX_LED: YELLOW; LED-1206-LTST-BOTTOM; MPN LTST-C230KSKT
U1: ATMEGA32U4-AU; TQFP44
U2: ICM-20689; QFN-24-4X4-0.9MM; MPN ICM-20689
U3: AP2210K-3.3TRG1; SOT23-5
U4: LM75AD; SOT96-1; MPN LM75AD,118
UP: MA01-1-ALLIGATOR-3.0MM
W: MA01-1-ALLIGATOR-3.0MM
Y1: 16Mhz; FA-238; MPN FA-238 16.0000MB-C3

Connections:
3.3V: C5.2, C6.2, C7.2, C10.2, R28.2, R29.2, TP1.TP, TR1.1 (G), TR2.1 (G), U2.8 (VDDIO), U2.13 (VDD), U2.22 (NCS), U3.5 (VOUT), U4.8 (VCC)
!RESET!: ISP.5, R3.1, U1.13 (!RESET)
A0: MOUSE-LEFT-CLICK.1@0, MOUSE-LEFT-CLICK.1@1, R24.1, U1.36 ((ADC7/TDI)PF7)
A1: MOUSE-RIGHT-CLICK.1@0, MOUSE-RIGHT-CLICK.1@1, R23.1, U1.37 ((ADC6/TDO)PF6)
A2: MOUSE-RIGHT.1@0, MOUSE-RIGHT.1@1, R22.1, U1.38 ((ADC5/TMS)PF5)
A3: MOUSE-LEFT.1@0, MOUSE-LEFT.1@1, R21.1, U1.39 ((ADC4/TCK)PF4)
A4: MOUSE-DOWN.1@0, MOUSE-DOWN.1@1, R20.1, U1.40 ((ADC1)PF1)
A5: MOUSE-UP.1@0, MOUSE-UP.1@1, R19.1, U1.41 ((ADC0)PF0)
D0: G.1@0, G.1@1, R18.1, U1.20 ((RXD1/INT2)PD2)
D1: F.1@0, F.1@1, R17.1, U1.21 ((TXD1/INT3)PD3)
D4: A.1@0, A.1@1, R14.1, U1.25 ((ICP1/ADC8)PD4)
D5: R13.1, U1.31 ((OC3A/!OC4A!)PC6), W.1@0, W.1@1
D6: CLICK.1@0, CLICK.1@1, R9.1, U1.27 ((T0/OC4D/ADC10)PD7)
D7: R8.1, SPACE.1@0, SPACE.1@1, U1.1 ((INT6/AIN0)PE6)
D8: DOWN.1@0, DOWN.1@1, R6.1, U1.28 ((PCINT4/ADC11)PB4)
D9: R10.1, U1.29 ((PCINT5/OC1A/!OC4B!/ADC12)PB5)
D10: R11.1, U1.30 ((PCINT6/OC1B/OC4B/ADC13)PB6)
D11: R12.1, U1.12 ((PCINT7/OC0A/OC1C/!RTS!)PB7)
D12: R4.1, U1.26 ((T1/!OC4D!/ADC9)PD6), UP.1@0, UP.1@1
D13: LEFT.1@0, LEFT.1@1, R5.1, U1.32 ((ICP3/CLK0/OC4A)PC7)
D14: ISP.1, U1.11 ((PDO/PCINT3/MISO)PB3)
D15: ISP.3, R7.1, RIGHT.1@0, RIGHT.1@1, U1.9 ((PCINT1/SCK)PB1)
D16: ISP.4, U1.10 ((PDI/PCINT2/MOSI)PB2)
GND: C1.1, C2.1, C3.1, C4.1, C5.1, C6.1, C7.1, C8.1, C9.1, C10.1, CN1.GND, CN1.SHLD@1 (SHLD), CN1.SHLD@2 (SHLD), CN1.SHLD@3 (SHLD), CN1.SHLD@4 (SHLD), CN1.SHLD@5 (SHLD), CN1.SHLD@6 (SHLD), EARTH1.1@0, EARTH1.1@1, EARTH2.1@0, EARTH2.1@1, EARTH3.1@0, EARTH3.1@1, EARTH4.1@0, EARTH4.1@1, EARTH5.1@0, EARTH5.1@1, ISP.6, ON.C, PC1.-, SJ1.1, U1.5 (UGND), U1.15 (GND), U1.23 (GND), U1.35 (GND), U1.43 (GND), U2.9 (AD0/SDO), U2.11 (FSYNC), U2.18 (GND), U2.25 (EPX_PAD), U3.2 (GND), U4.4 (GND), U4.5 (A2), U4.6 (A1), U4.7 (A0), Y1.2, Y1.4
HWB: SJ1.2, U1.33 (PE2(!HWB))
unnamed: C4.2, U1.42 (AREF)
unnamed: C1.2, U1.17 (XTAL1), Y1.1
unnamed: C2.2, U1.16 (XTAL2), Y1.3
unnamed: LED_CLICK.A, LED_DOWN.A, LED_LEFT.C, LED_SPACE.C, R10.2
unnamed: CN1.VBUS, F1.1
unnamed: C3.2, U1.6 (UCAP)
unnamed: CN1.D-, R1.1
unnamed: R1.2, U1.3 (D-)
unnamed: R2.2, U1.4 (D+)
unnamed: CN1.D+, R2.1
unnamed: LED_CLICK.C, LED_RIGHT.A, LED_SPACE.A, LED_UP.C, R12.2
unnamed: LED_DOWN.C, LED_LEFT.A, LED_RIGHT.C, LED_UP.A, R11.2
unnamed: C9.2, U2.10 (REGOUT)
unnamed: R25.1, TX_LED.A
unnamed: R26.1, RX_LED.A
unnamed: ON.A, R27.1
RX_LED: RX_LED.C, U1.8 ((SS/PCINT0)PB0)
SCL_HV: R31.1, TR2.3 (D), U1.18 ((OC0B/SCL/INT0)PD0)
SCL_LV: R29.1, TR2.2 (S), U2.23 (SCL/SCLK), U4.2 (SCL)
SDA_HV: R30.1, TR1.3 (D), U1.19 ((SDA/INT1)PD1)
SDA_LV: R28.1, TR1.2 (S), U2.24 (SDA/SDI), U4.1 (SDA)
TX_LED: TX_LED.C, U1.22 ((XCK1/!CTS!)PD5)
VCC: C8.2, F1.2, ISP.2, PC1.+, R3.2, R4.2, R5.2, R6.2, R7.2, R8.2, R9.2, R13.2, R14.2, R17.2, R18.2, R19.2, R20.2, R21.2, R22.2, R23.2, R24.2, R25.2, R26.2, R27.2, R30.2, R31.2, U1.2 (UVCC), U1.7 (VBUS), U1.14 (VCC), U1.24 (AVCC), U1.34 (VCC), U1.44 (AVCC), U3.1 (VIN), U3.3 (EN)

Notes on the sheet:
ACCELEROMETER
TEMPERATURE
3.3V
MAIN MICROCONTROLLER

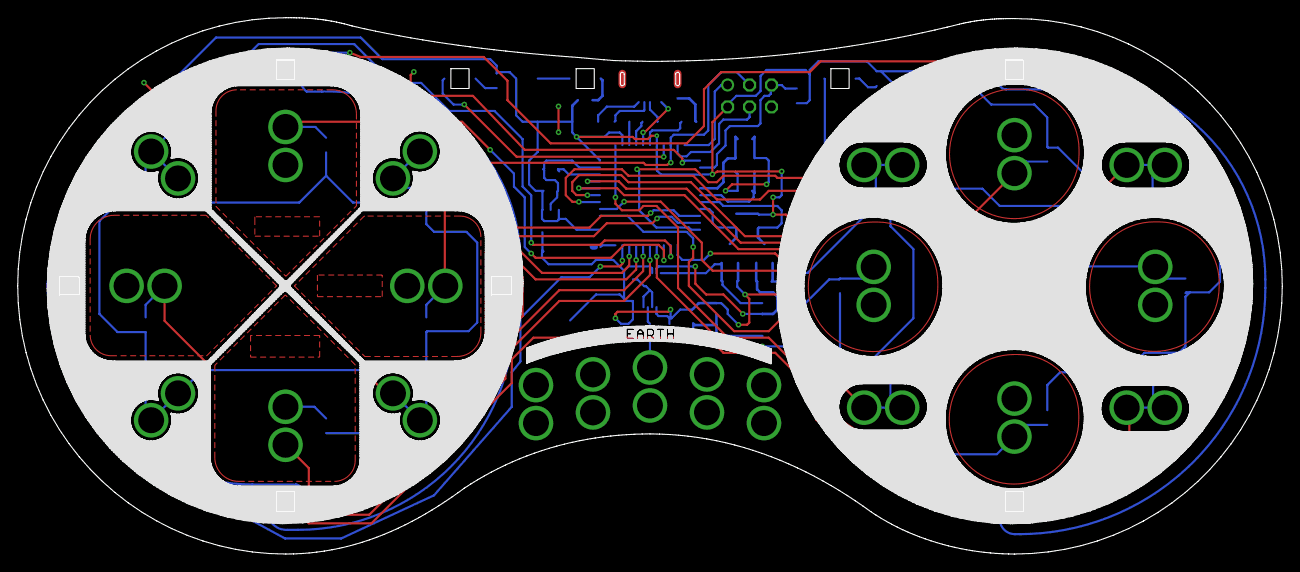
[picture p29: board Shakey.brd from above]

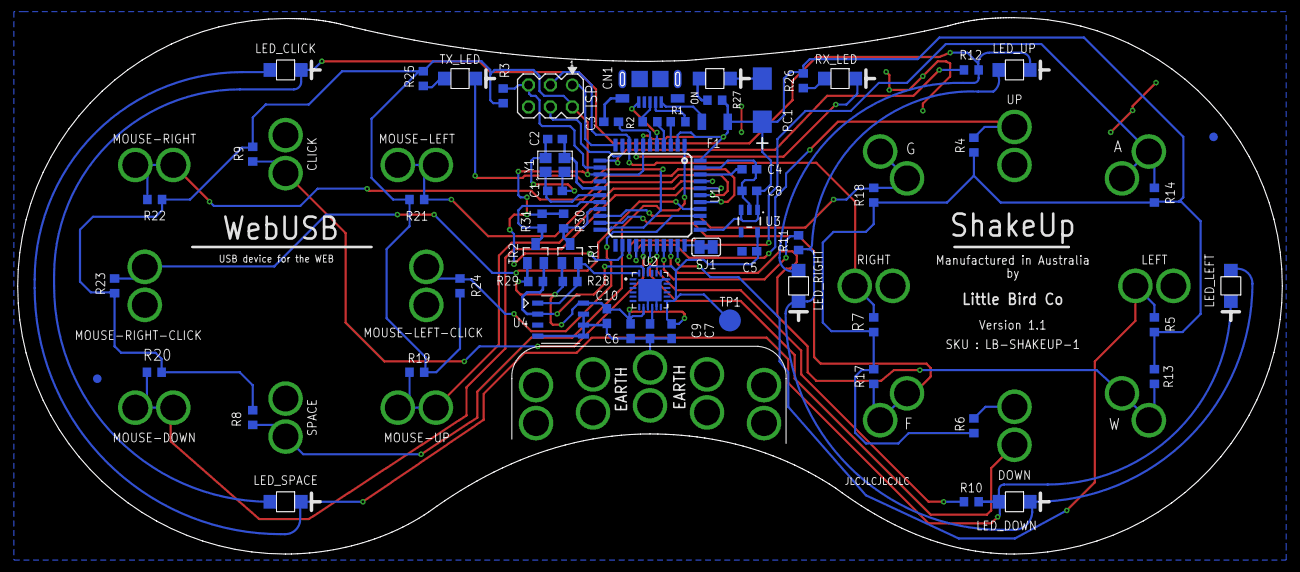
[picture p30: board Shakey.brd from below]

Board: 2 copper layers, 146.4 x 62.1 mm, 84 parts (84 on the bottom side), 48 nets.
