littlebirdelectronics/shakey/(commit log)

2018-09-06 completed basic schematic
    [Shakey.brd, Shakey.sch]
2018-09-07 completed schematic
    [Shakey.brd, Shakey.sch]
2018-09-07 rearranged level shifter
    [Shakey.brd, Shakey.sch]
2018-09-08 added controller outline
    [SNES.dxf, SNES_Outline.dxf, Shakey.brd]
2018-09-10 added LM75
    [Shakey.brd, Shakey.sch]
2018-09-12 90 percent parts placed
    [SNES_Outline.dxf, SNES_Outline2.dxf, Shakey.brd, Shakey.sch]
2018-09-12 completed arranging parts
    [Shakey.brd]
2018-09-13 50 percent tracks done
    [Shakey.brd, Shakey.sch]
2018-09-14 finished tracks
    [Shakey.brd]
2018-09-14 working on silkscreen design
    [Shakey.brd, Shakey.sch]
2018-09-20 sent board for prototyping
    [Shakey.brd]
2018-09-21 added BOM with attributes
    [Shakey.brd, Shakey.sch]
2018-10-24 added fiducial, branding text,logo
    [Shakey.brd, Shakey.sch, Shakey_default_BOM_values.xls, logo.dxf, shakey-logo.dxf, test.dxf]
2018-10-26 added Australian Made logo, adjusted some text to make them even
    [Shakey.brd, Shakey.sch]
2018-10-26 updated expenses files
    [Australian_Made.dxf, Australian_Made2.dxf, Australian_Made6.dxf, test_made_in_australia.dxf]
2018-11-06 ready for production
    [Shakey.brd, Shakey.sch, Shakey_default_BOM_values.xls]
2018-11-07 generated production gerber
    [2018-11-02T052132.xlsx]
2018-11-09 added Australian Made Logo
    [Australian-Made.dxf, Australian_Made.dxf, Australian_Made2.dxf, Australian_Made6.dxf, Shakey.brd]
2018-11-12 changed croc hole to 3.0mm
    [Shakey.brd, Shakey.sch]
2018-12-04 correct Micro USB value for P&P
    [Outline.dxf, Shakey-Outline.dxf, Shakey.brd, Shakey.dxf, Shakey.sch, Untitled.dxf, side_holder.dxf]
2019-03-15 added part value for P&P
    [Shakey.brd, Shakey.sch]
2019-03-15 added Testjig images
    [TestJig.dxf, TestJig.sch]
2019-03-22 getting ready to port to github
    [Shakey_default_BOM_values.csv]
2019-04-15 added Production test folder
    [TestJig.sch]
2019-06-05 changed name to ShakeUp
    [SNES_Outline2.dxf, Shakey.brd, TestJig.sch]
